Karttttt/STM32-Health-Monitor/Hardware/buzzer.c

#include "buzzer.h"

void Buzzer_Init(void)
{
    GPIO_InitTypeDef GPIO_InitStructure;
    
    // 开启 GPIOA 时钟
    RCC_APB2PeriphClockCmd(RCC_APB2Periph_GPIOA, ENABLE);

    // 配置 PA1 为推挽输出
    GPIO_InitStructure.GPIO_Pin = BUZZER_PIN;
    GPIO_InitStructure.GPIO_Mode = GPIO_Mode_Out_PP; 
    GPIO_InitStructure.GPIO_Speed = GPIO_Speed_50MHz;
    GPIO_Init(BUZZER_PORT, &GPIO_InitStructure);

    // ⚠️ 极其重要：初始化后立刻输出高电平，防止上电就一直叫
    BUZZER_OFF(); 
}
