Karttttt/STM32-Health-Monitor/(commit log)

2026-10-28 chore: 添加 .gitignore，排除 Keil 编译产物与本机个人配置
2026-10-28 feat: STM32F103C8T6 多维生理特征与跌倒预警监测固件
    - 基于 1ms 系统滴答的非阻塞时间片轮转调度框架
    - MAX30102 心率血氧采集 + AMPD 自适应多尺度峰值检测算法
    - MPU6050 三轴加速度差分平方和跌倒判定（±2g，阈值 0.5g²）
    - DS18B20 单总线体温采集、SSD1306 OLED 本地显示、蜂鸣器告警
    - USART1 每 100ms 输出 UTF-8 JSON 数据帧供 ESP8266 转发上位机
2026-10-28 docs: 添加毕业论文、开题报告与答辩 PPT
2026-10-28 docs: 添加项目 README，说明系统架构、引脚分配、调度时序与串口协议
2026-10-28 docs: 修正 I2C 总线数量与 MPU6050 输出频率的描述
